ScribbleJ/corexy-v1/(list of files, cad)

Other CAD files:
bearing_mount_cap.scad
