ScribbleJ/corexy-v1/(commit log)

2014-06-19 Added polyhole()
    [core.scad]
2014-06-20 Still working
    [core.scad, vars.scad]
2014-06-21 Fixed X Mount Holes, Motor Y Rod Attachment
    [core.scad, vars.scad]
2014-06-21 iFixed X mount sep
    [core.scad]
2014-06-22 All but Z complted.
    [core.scad, vars.scad]
2014-07-17 Lots of updates
    [common.scad, core.scad, extender.scad, platform.scad, standardextruder.scad, vars.scad, z_parts.scad]
2014-07-19 Platform supported at both ends.
    [platform.scad, vars.scad]
2014-07-25 Final commit before lm8uu change
    [bowdenmount.scad, core.scad, jhead.bowden.scad, vars.scad]
2014-07-27 Initial updates for 50mm X-rod
    [core.scad, jhead.bowden.scad, standardextruder.scad, vars.scad]
2014-07-28 LCD mount, changes to assembly display
    [core.scad, platform.scad, rrd-graphic.scad, z_parts.scad]
2014-07-31 Fixes to corners
    [core.scad]
2014-07-31 Assembly fixed.
    [core.scad]
2014-07-31 Break out parts into separate files.
    [bearing_mount.scad, bearing_mount_cap.scad, bearing_retainer.scad, belt_clamp.scad, common.scad, core.scad, core_assembly.scad, corner.scad]
2014-07-31 Add comments with parts to print on each file
    [bearing_mount.scad, bearing_mount_cap.scad, bearing_retainer.scad, belt_clamp.scad, bowdenmount.scad, common.scad, core_assembly.scad, corner.scad]
2014-08-01 Commented some variables, added some instruction.
    [vars.scad]
2014-08-08 Added fan mount for 'standardextruder'
    [standardfan.scad]
2014-08-08 Needs vars changed to correct sizes
    [standardfan.scad]
